spbnick/lopill/README.md

LoPill
=======

LoPill is a minimal development board for STM32L052C8T6 microcontroller, in
the form-factor of the popular "Blue Pill".

This work is licensed under a [Creative Commons Attribution-ShareAlike 4.0
International License](http://creativecommons.org/licenses/by-sa/4.0/).
