spbnick/lopill/models/8mhz_crystal.FCStd

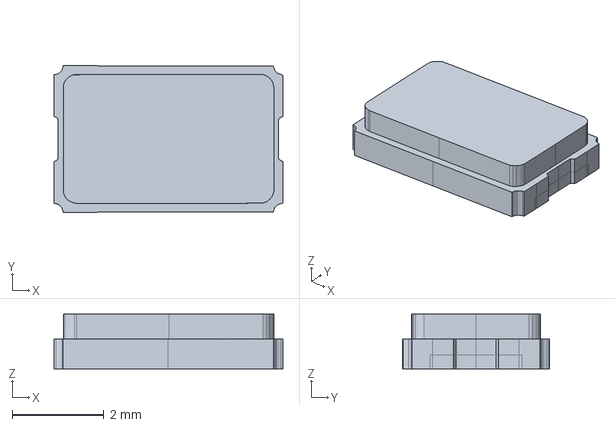
[picture p1: CAD file, 2020-07-31]
models/8mhz_crystal.FCStd
5.00 x 3.20 x 1.20 mm
