spbnick/lopill/lopill.kicad/lopill.kicad_pcb

## KiCad design lopill.kicad/lopill.kicad_pcb (2022-05-14)

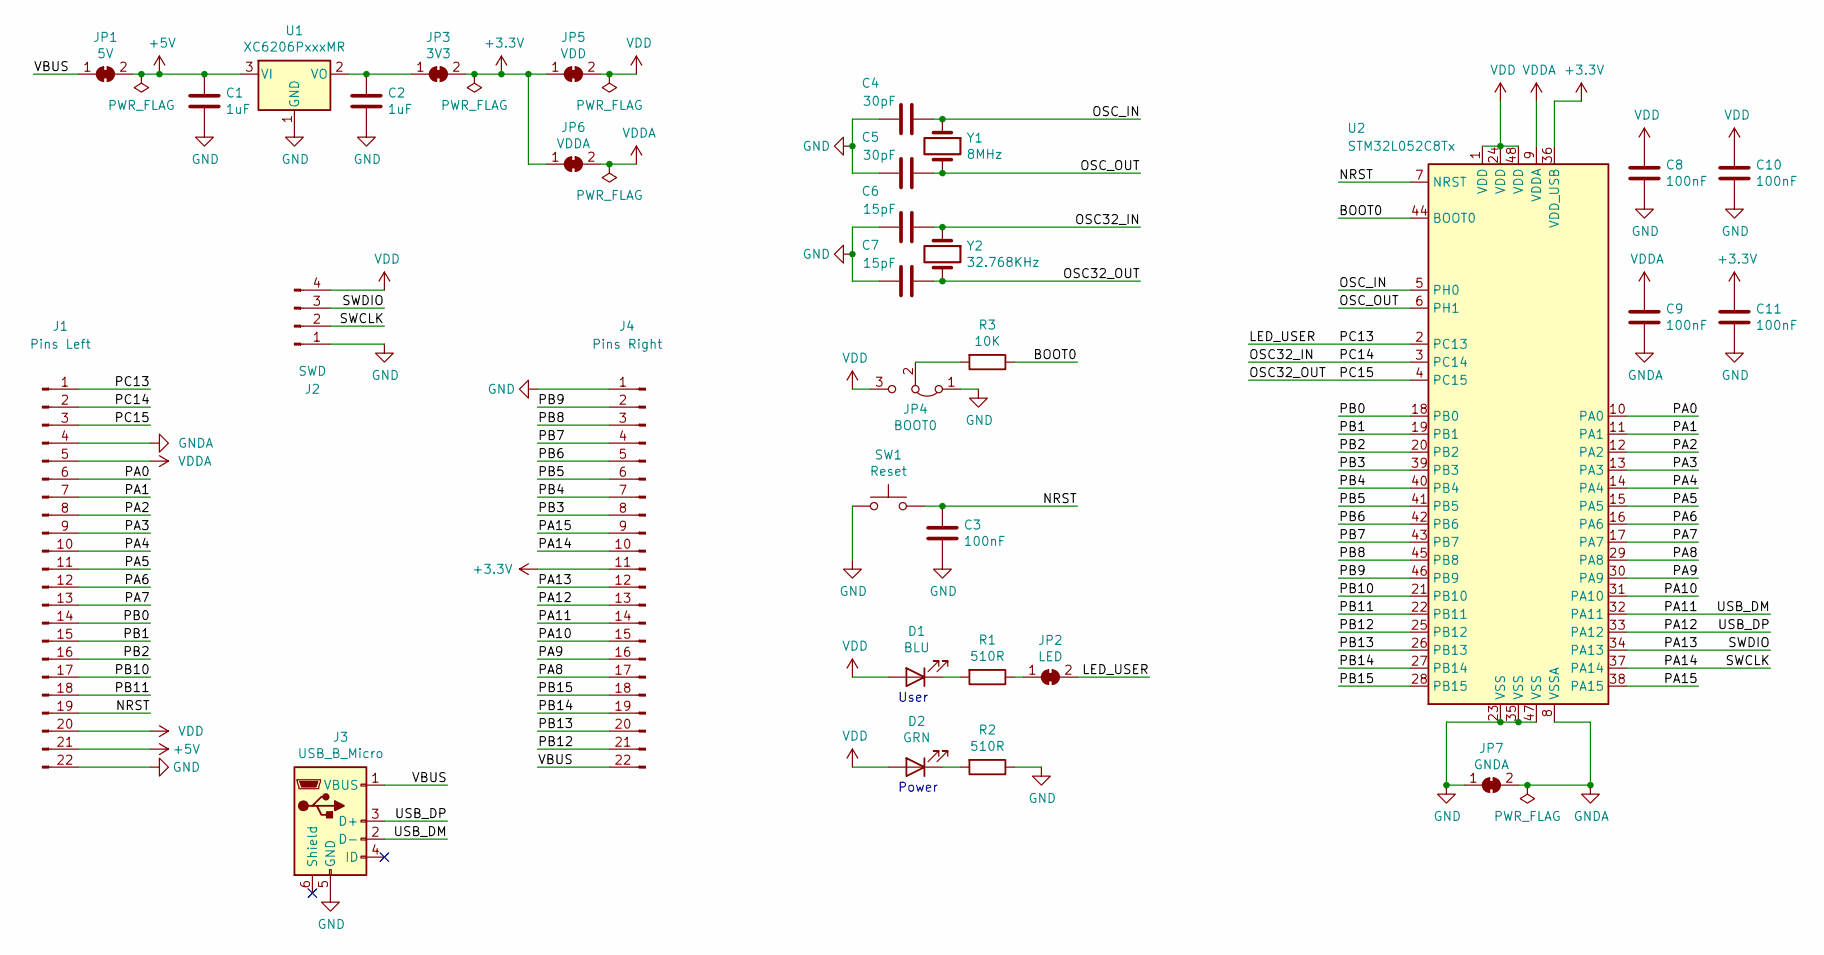
[picture p2: schematic lopill.kicad_sch, LoPill STM32L052C8T6 development board]

Parts:
C1, C2: 1uF; C_0402_1005Metric; LCSC C52923
C3, C8, C9, C10, C11: 100nF; C_0402_1005Metric; LCSC C1525
C4, C5: 30pF; C_0402_1005Metric; LCSC C159804
C6, C7: 15pF; C_0402_1005Metric; LCSC C1548
D1: BLU; LED_0603_1608Metric; LCSC C72041
D2: GRN; LED_0603_1608Metric; LCSC C72043
J1: Pins Left; PinHeader_1x22_P2.54mm_Vertical
J2: SWD; PinHeader_1x04_P2.54mm_Vertical
J3: USB_B_Micro; USB_Micro-B_HRO_U-D-M5DD-W-1_Vertical; LCSC C145795
J4: Pins Right; PinHeader_1x22_P2.54mm_Vertical
JP1: 5V; SolderJumper-2_P1.3mm_Bridged2Bar_RoundedPad1.0x1.5mm
JP2: LED; SolderJumper-2_P1.3mm_Bridged2Bar_RoundedPad1.0x1.5mm
JP3: 3V3; SolderJumper-2_P1.3mm_Bridged2Bar_RoundedPad1.0x1.5mm
JP4: BOOT0; PinHeader_1x03_P2.54mm_Vertical
JP5: VDD; SolderJumper-2_P1.3mm_Bridged2Bar_RoundedPad1.0x1.5mm
JP6: VDDA; SolderJumper-2_P1.3mm_Bridged2Bar_RoundedPad1.0x1.5mm
JP7: GNDA; SolderJumper-2_P1.3mm_Bridged2Bar_RoundedPad1.0x1.5mm
R1, R2: 510R; R_0402_1005Metric; LCSC C25123
R3: 10K; R_0402_1005Metric; LCSC C25744
SW1: Reset; SW_Push_1P1T_NO_5.1x5.1mm_H2.5mm; LCSC C318887
U1: XC6206PxxxMR; SOT-23; LCSC C5446
U2: STM32L052C8Tx; LQFP-48_7x7mm_P0.5mm; LCSC C111213
Y1: 8MHz; Crystal_SMD_5032-2Pin_5.0x3.2mm_YXC; LCSC C115962
Y2: 32.768KHz; Crystal_SMD_3215-2Pin_3.2x1.5mm; LCSC C32346

Connections:
+3V3: C11.1, J4.11, JP3.2 (B), JP5.1 (A), JP6.1 (A), U2.36 (VDD_USB)
+5V: C1.1, J1.21, JP1.2 (B), U1.3 (VI)
/BOOT0: R3.1, U2.44 (BOOT0)
/LED_USER: J1.1, JP2.2 (B), U2.2 (PC13)
/NRST: C3.1, J1.19, SW1.2, U2.7 (NRST)
/OSC32_IN: C6.1, J1.2, U2.3 (PC14), Y2.1
/OSC32_OUT: C7.1, J1.3, U2.4 (PC15), Y2.2
/OSC_IN: C4.1, U2.5 (PH0), Y1.1
/OSC_OUT: C5.1, U2.6 (PH1), Y1.2
/PA0: J1.6, U2.10 (PA0)
/PA1: J1.7, U2.11 (PA1)
/PA2: J1.8, U2.12 (PA2)
/PA3: J1.9, U2.13 (PA3)
/PA4: J1.10, U2.14 (PA4)
/PA5: J1.11, U2.15 (PA5)
/PA6: J1.12, U2.16 (PA6)
/PA7: J1.13, U2.17 (PA7)
/PA8: J4.17, U2.29 (PA8)
/PA9: J4.16, U2.30 (PA9)
/PA10: J4.15, U2.31 (PA10)
/PA11: J3.2 (D-), J4.14, U2.32 (PA11)
/PA12: J3.3 (D+), J4.13, U2.33 (PA12)
/PA13: J2.3, J4.12, U2.34 (PA13)
/PA14: J2.2, J4.10, U2.37 (PA14)
/PA15: J4.9, U2.38 (PA15)
/PB0: J1.14, U2.18 (PB0)
/PB1: J1.15, U2.19 (PB1)
/PB2: J1.16, U2.20 (PB2)
/PB3: J4.8, U2.39 (PB3)
/PB4: J4.7, U2.40 (PB4)
/PB5: J4.6, U2.41 (PB5)
/PB6: J4.5, U2.42 (PB6)
/PB7: J4.4, U2.43 (PB7)
/PB8: J4.3, U2.45 (PB8)
/PB9: J4.2, U2.46 (PB9)
/PB10: J1.17, U2.21 (PB10)
/PB11: J1.18, U2.22 (PB11)
/PB12: J4.21, U2.25 (PB12)
/PB13: J4.20, U2.26 (PB13)
/PB14: J4.19, U2.27 (PB14)
/PB15: J4.18, U2.28 (PB15)
/VBUS: J3.1 (VBUS), J4.22, JP1.1 (A)
GND: C1.2, C2.2, C3.2, C4.2, C5.2, C6.2, C7.2, C8.2, C10.2, C11.2, J1.22, J2.1, J3.5 (GND), J4.1, JP4.1 (A), JP7.1 (A), R2.1, SW1.1, U1.1 (GND), U2.23 (VSS), U2.35 (VSS), U2.47 (VSS)
GNDA: C9.2, J1.4, JP7.2 (B), U2.8 (VSSA)
unnamed: C2.1, JP3.1 (A), U1.2 (VO)
unnamed: D1.1 (K), R1.2
unnamed: D2.1 (K), R2.2
unnamed: JP2.1 (A), R1.1
unnamed: JP4.2 (C), R3.2
VDD: C8.1, C10.1, D1.2 (A), D2.2 (A), J1.20, J2.4, JP4.3 (B), JP5.2 (B), U2.1 (VDD), U2.24 (VDD), U2.48 (VDD)
VDDA: C9.1, J1.5, JP6.2 (B), U2.9 (VDDA)

Notes on the sheet:
Power
User

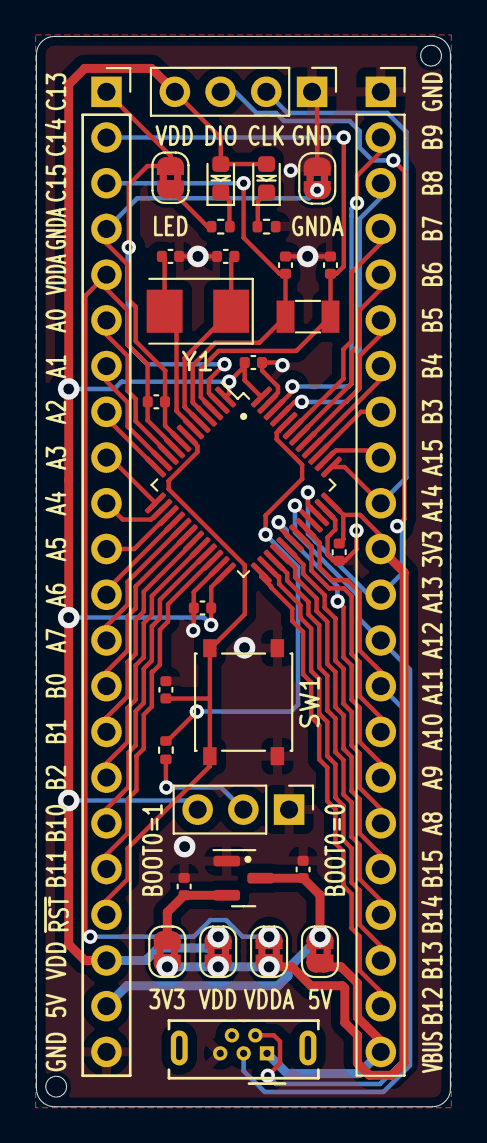
[picture p3: board lopill.kicad_pcb from above]

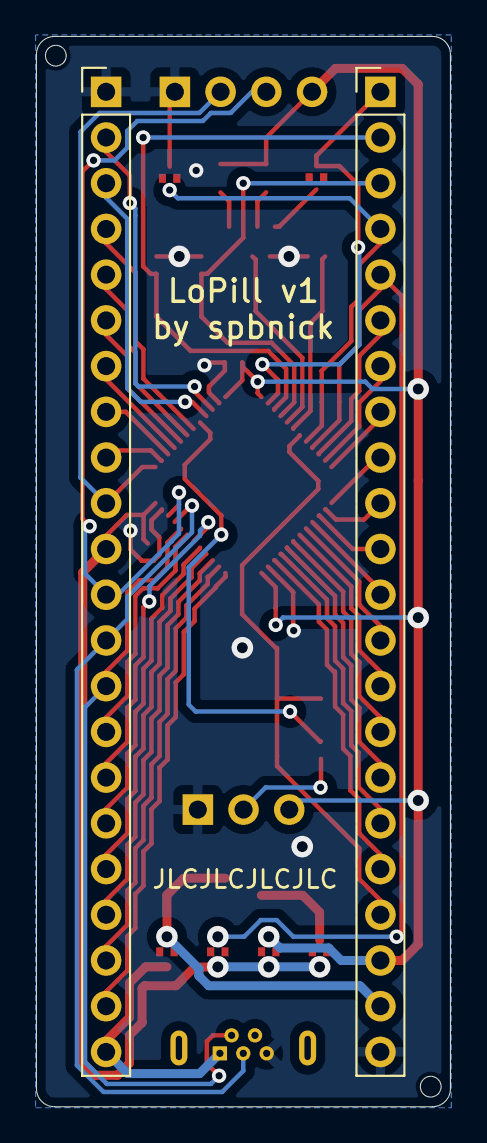
[picture p4: board lopill.kicad_pcb from below]

Board: 2 copper layers, 23.0 x 59.5 mm, 32 parts (2 on the bottom side), 51 nets.
