spbnick/lopill/(commit log)

2020-07-30 Add review-ready board
    [lopill.kicad_pcb, lopill.sch]
2020-07-31 Add 3D model of 8MHz crystal
    [8mhz_crystal.FCStd, lopill.kicad_pcb, lopill.sch]
2020-07-31 Lighten attribution text on back silkscreen
    [lopill.kicad_pcb]
2020-07-31 Add JLCJLCJLCJLC placeholder
    [lopill.kicad_pcb]
2020-08-01 Make lower jumper names appear on gerbers
    [lopill.kicad_pcb]
2020-08-01 Make upper jumper names appear on gerbers
    [lopill.kicad_pcb]
2020-10-03 Switch to using the new rcc.h
2020-10-11 Add I2C example code
2020-10-11 Lower I2C display brightness to avoid overheating
    [i2c.c]
2020-10-13 Expand TSC example to two sensor channels
2020-12-13 Add KiCAD rescue library
2020-12-13 usart: Fix alternate function assignment
    [usart.c]
2021-01-07 Switch blink.c to GPIO config functions
2022-05-14 Disconnect USB shield from ground
    [lopill.sch]
2022-05-14 Upgrade to KiCAD v6
    [lopill.kicad_pcb, lopill.kicad_sch]
2022-05-14 Move footprints to the shared library
    [lopill.kicad_pcb, lopill.kicad_sch]
